genffy/diy-oxygen-pump/(commit log)

2026-06-23 🐟 DIY 鱼缸充氧泵 — ESP8266 + Kamoer HDVP1-B6, 手机WiFi控制+PWM调速
    - Wemos D1 mini (ESP8266) 作为 WiFi 热点 + Web 服务器
    - Kamoer HDVP1-B6 无刷气泵, PWM 调速 (10%-100%)
    - 手机浏览器控制: 开关、定时、调速
    - 设置 EEPROM 断电记忆
    - 只需 3 根杜邦线, 无需 MOS 模块
2026-10-13 feat(firmware): 每日定时开关 + NTP 校时;.env 凭据注入与一键烧录脚本
    - 每日运行窗口(支持跨午夜),窗口内连续运行或间歇循环
    - AP+STA 双模:保留手机热点,同时连家庭路由器做 NTP 校时(UTC+8)
    - 设置结构 v2:旧版 EEPROM 数据自动迁移,升级后行为不变
    - /set 表单改 POST 防浏览器预取误改,/state 增加计划与时间状态字段
    - 修复:间歇循环 off<=on 时同轮先关后开永不休息;手动开重启后不恢复运行
    - Wi-Fi 凭据移入 .env.local(git 忽略),scripts/flash.sh 生成
    oxygen_pump.ino.globals.h 编译期注入,源码不再含密钥
    - README/设计文档同步更新,补充每日计划界面截图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
    [oxygen_pump.ino]
